Deb-roop/Design-and-Implementation-of-3-Digit-Random-Number-Generator-/(list of files, drawings)

Other design files:
Proteus simulation of 3 Digit Random Number Generator .pdsprj
